Brandon-Valley/Charger-Automation-Board/Car Charger Stuff.docx

Formula Electric

Car Charger

I2C isolator: ISO1541DR

MOSFET: CSD17506Q5A

Low-side MOSFET driver: FAN3214

Cable-pic on phone
