Brandon-Valley/Charger-Automation-Board/Artemis Charger Mod PCB.2.dxf

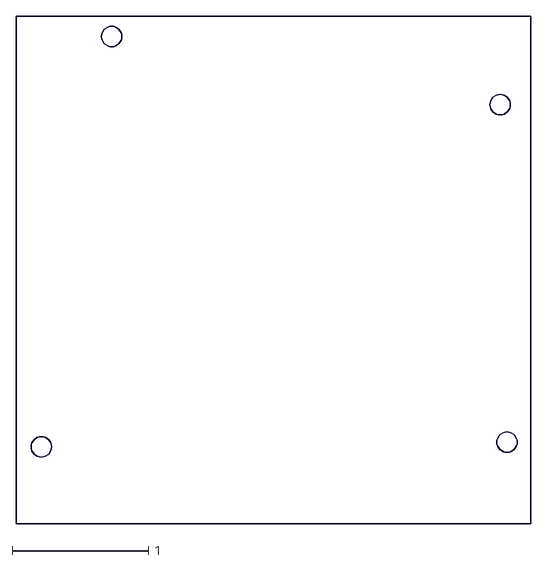
[picture p1: CAD file, 2016-02-05]
Artemis Charger Mod PCB.2.dxf
3.77 x 3.72
