Brandon-Valley/Charger-Automation-Board/Artemis Charger Mod PCB.2.brd

## EAGLE design Artemis Charger Mod PCB.2.brd (2016-01-29)

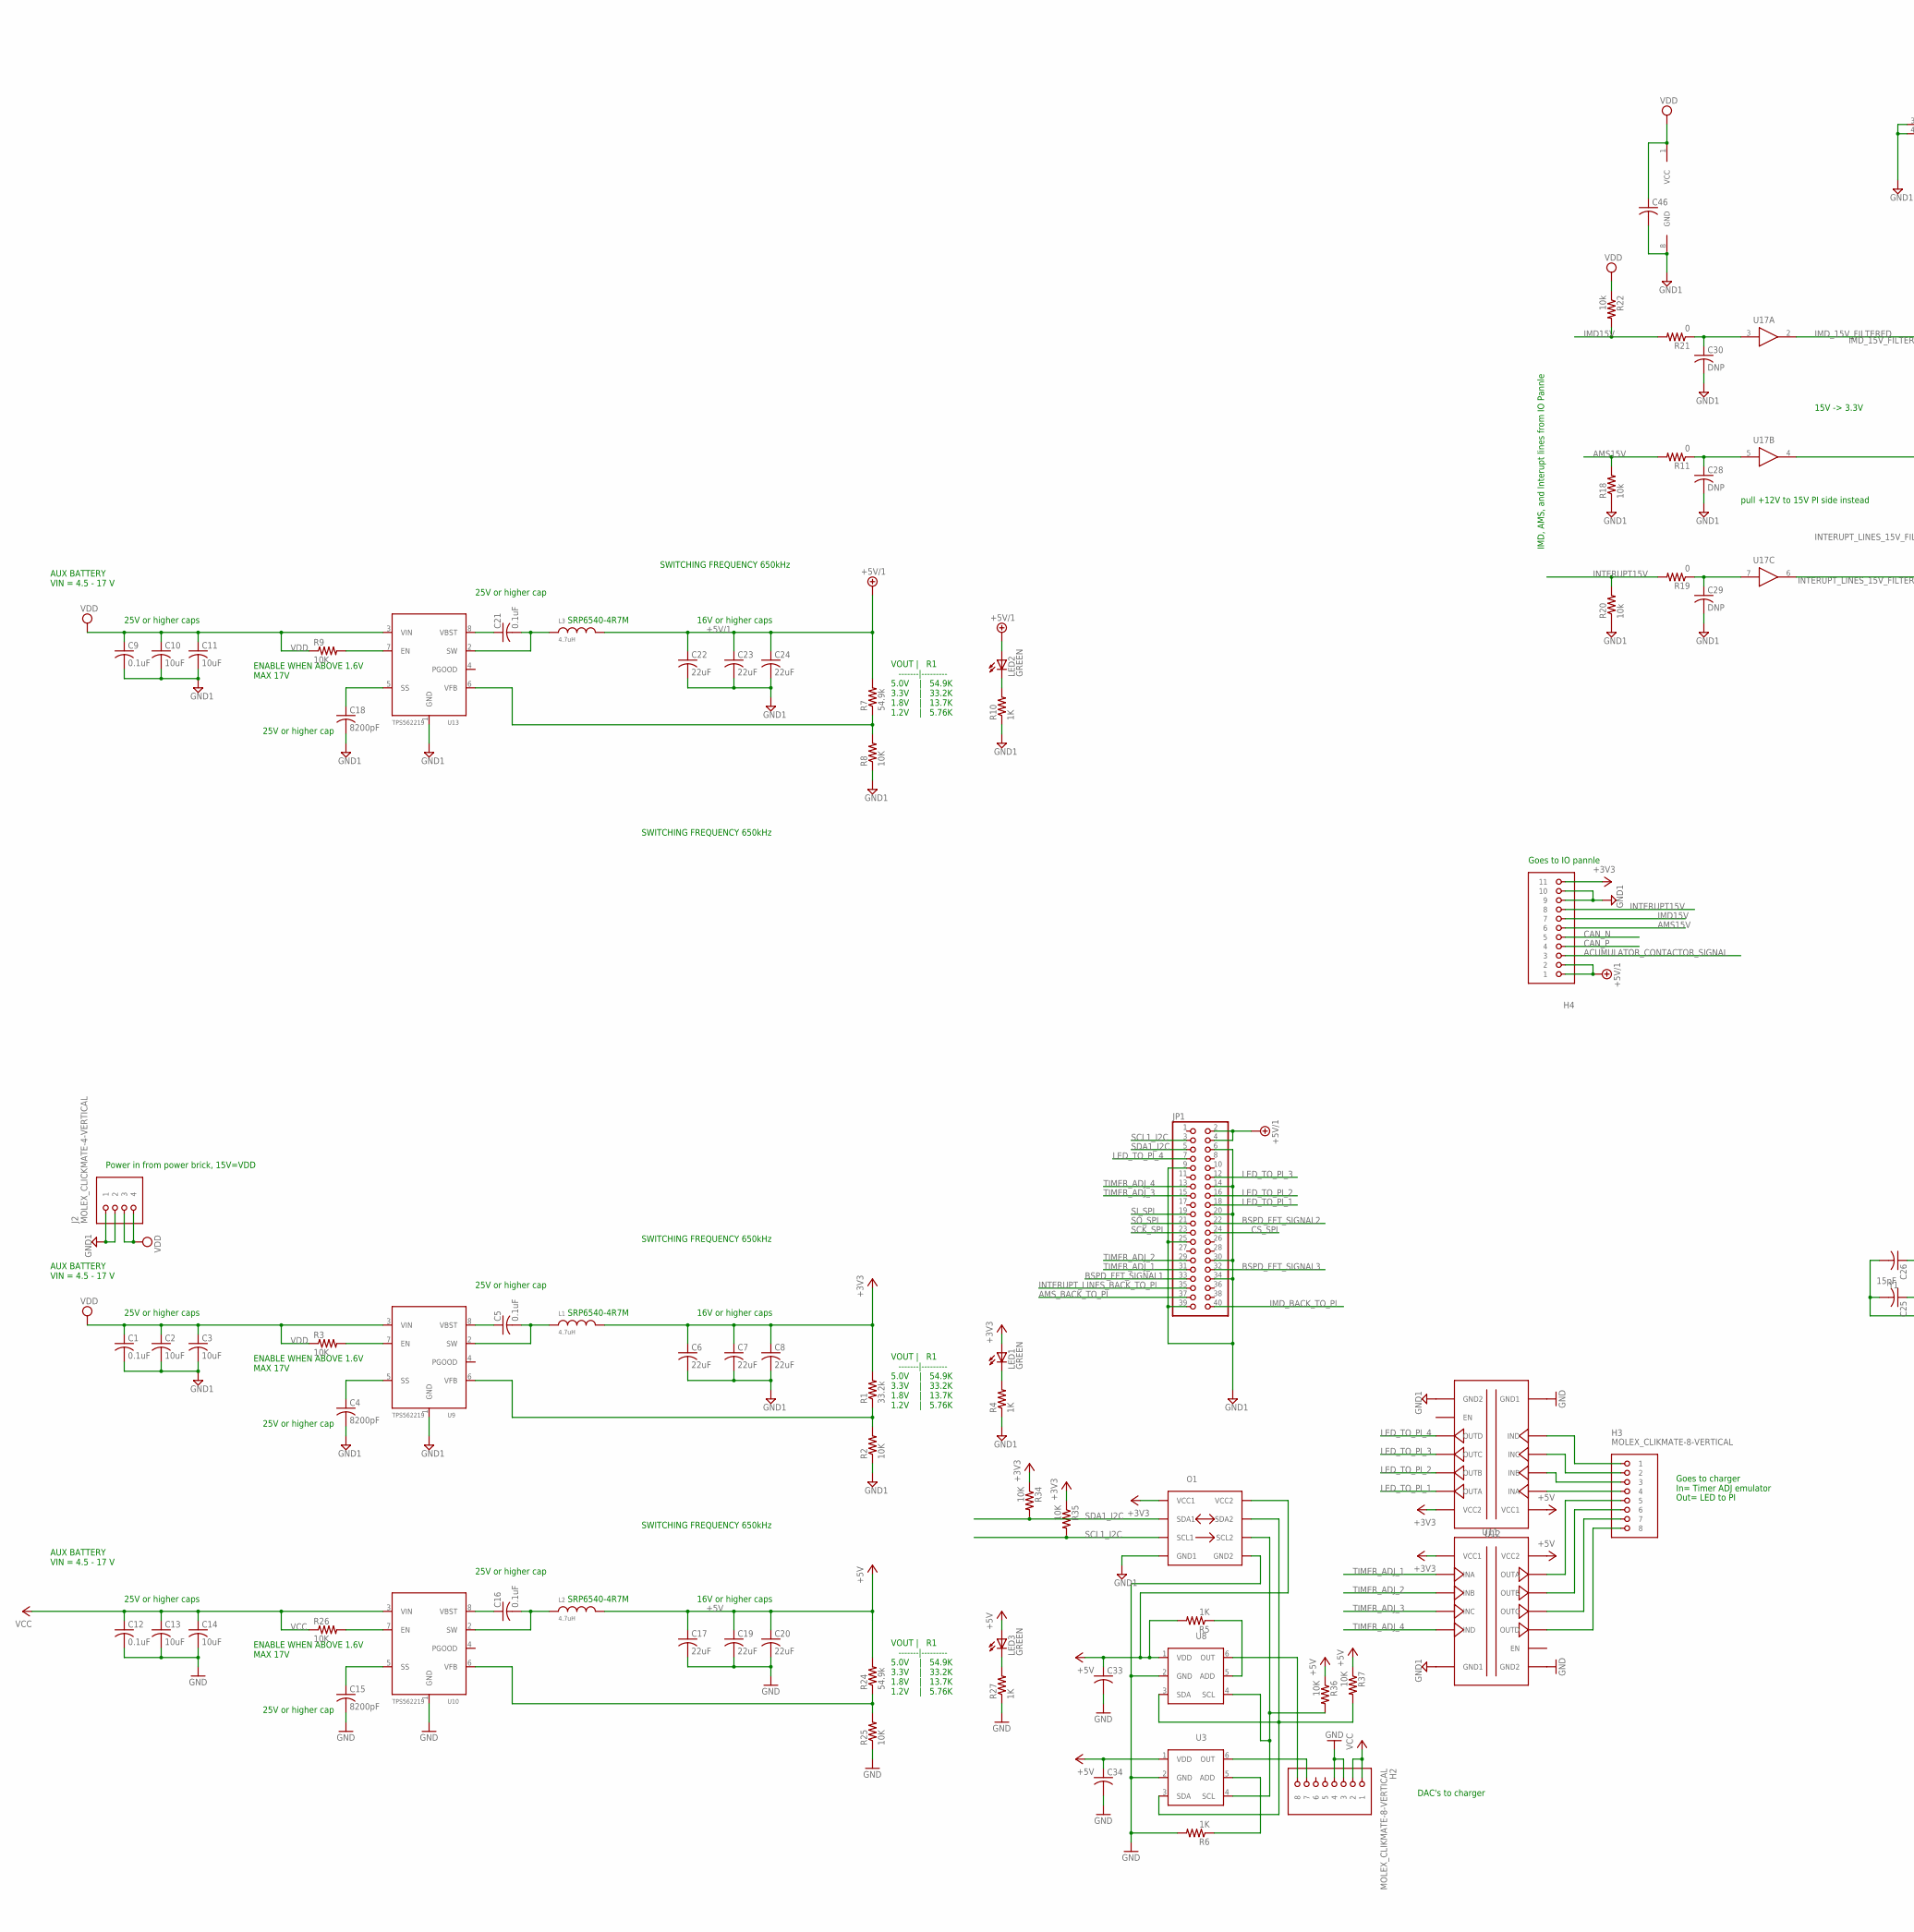
[picture p2: schematic Artemis Charger Mod PCB.2.sch, part in row 1, column 1]

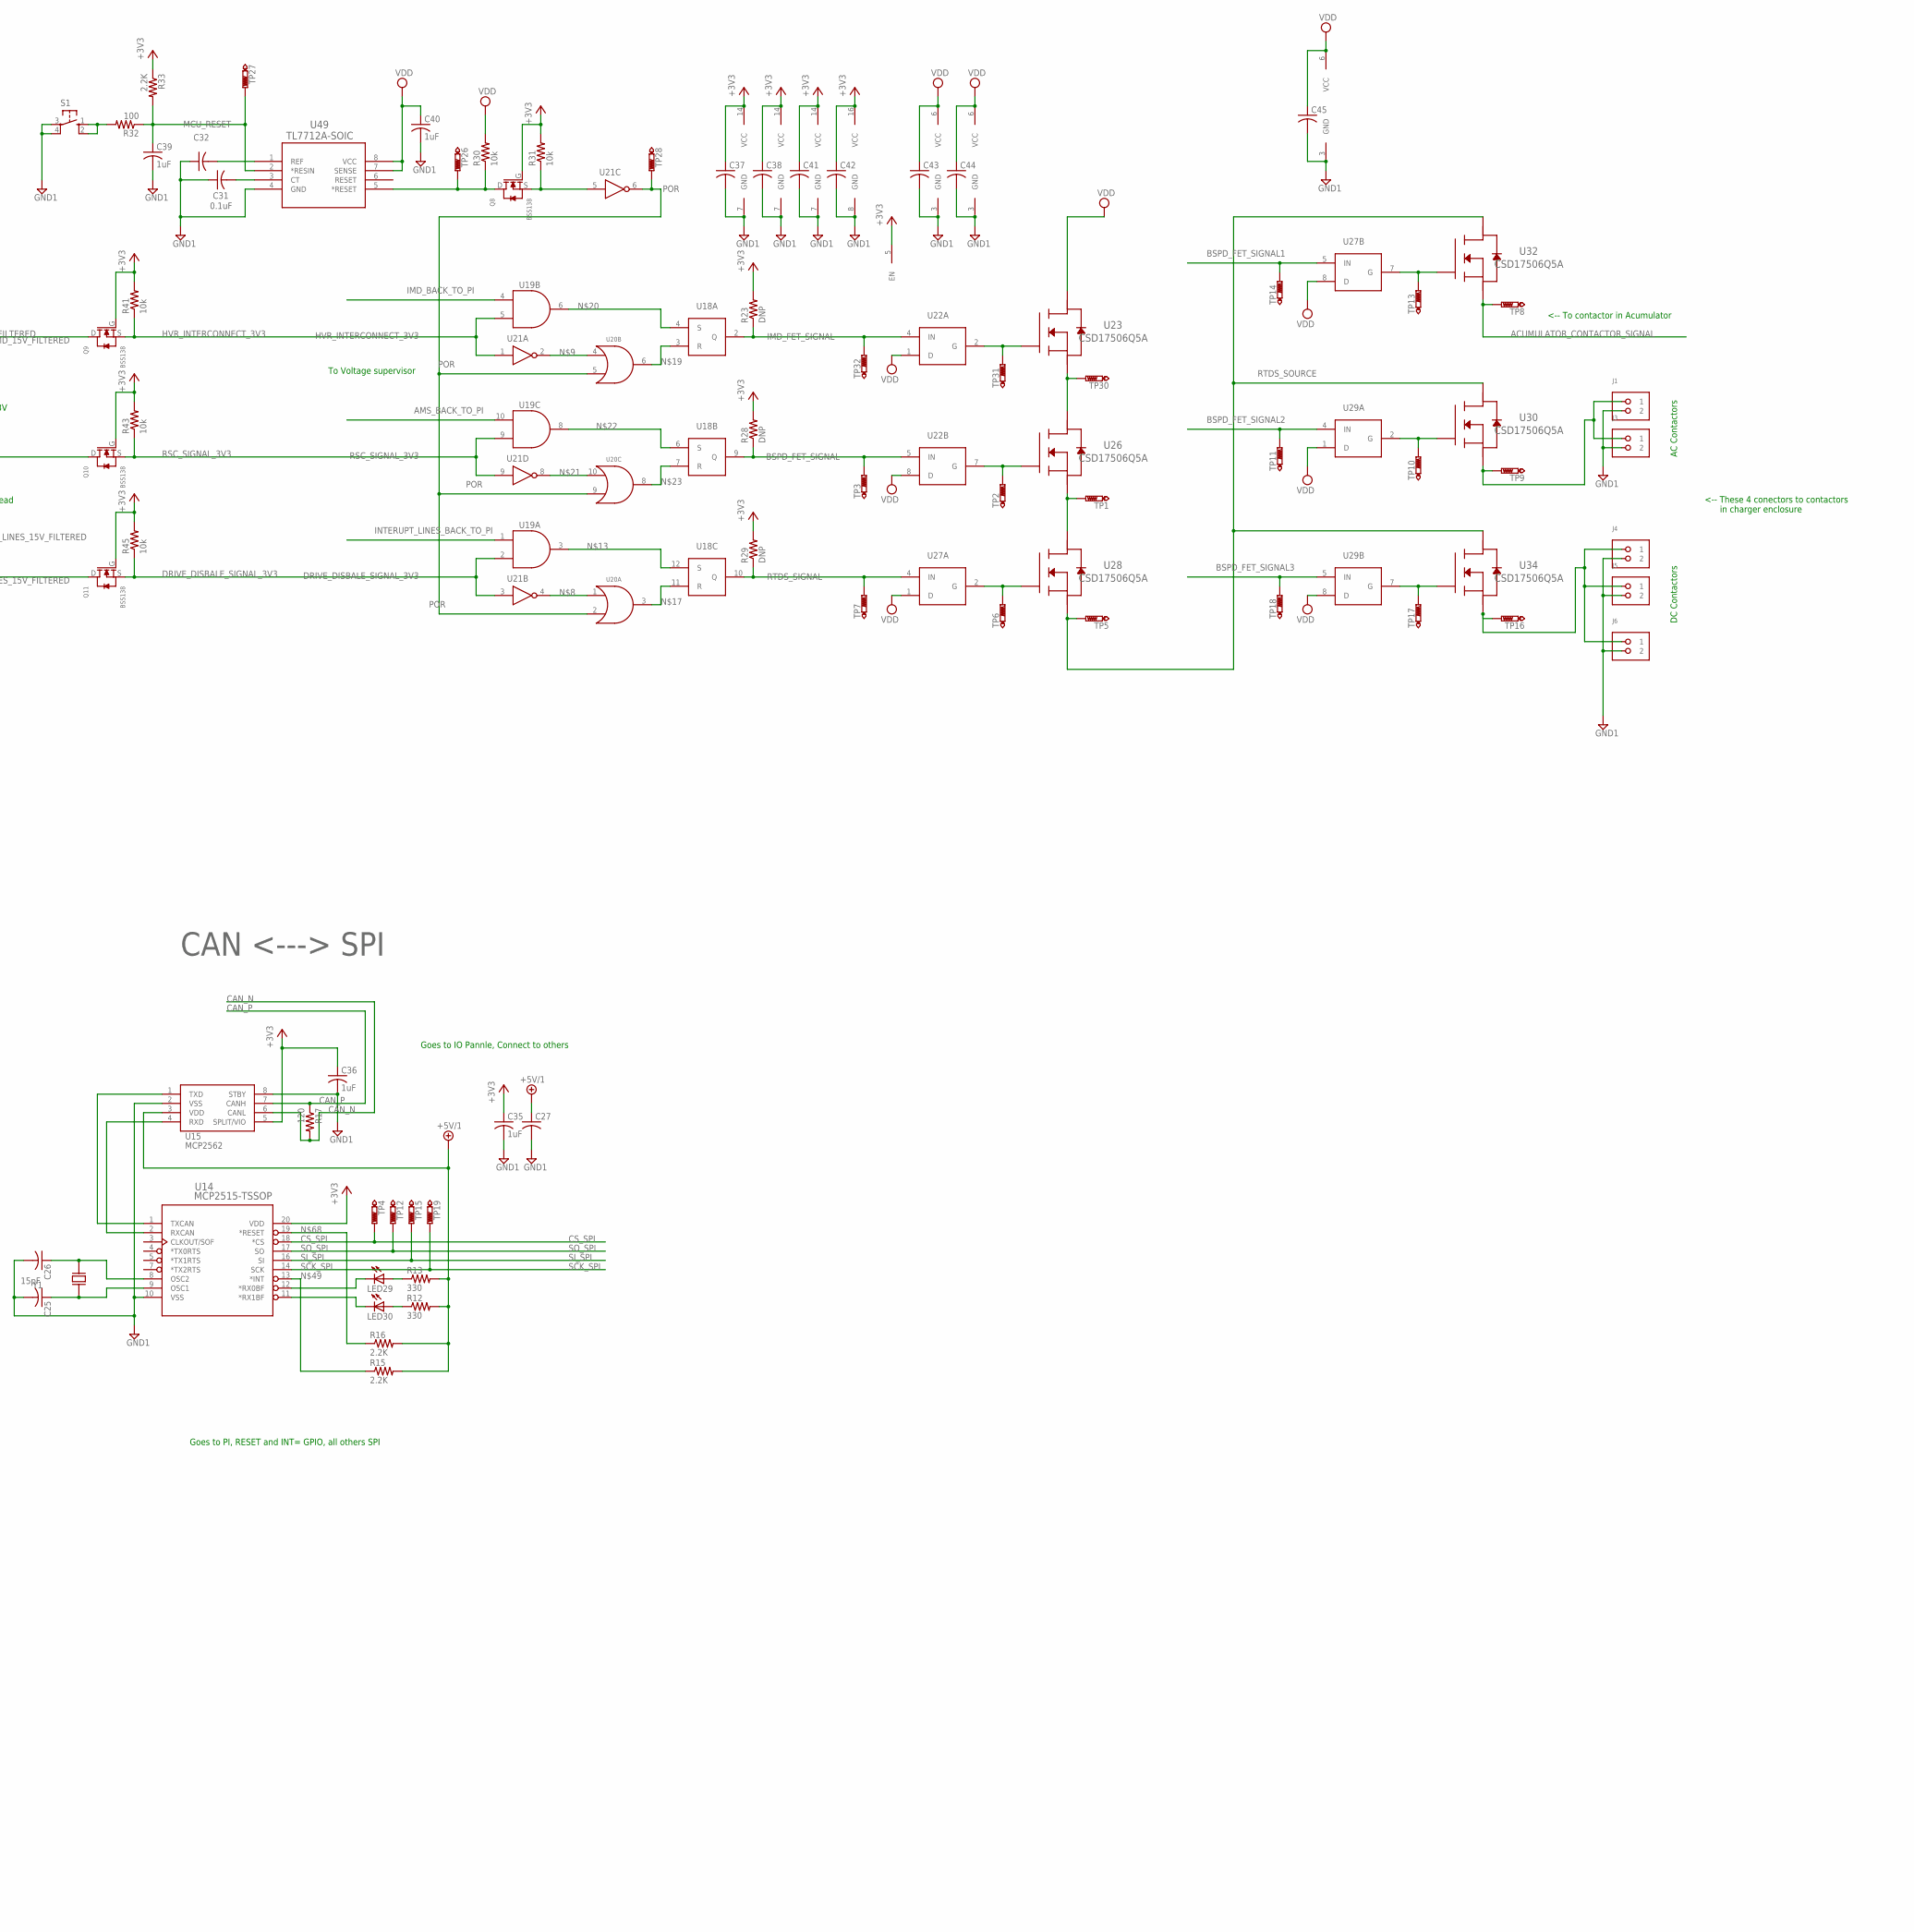
[picture p3: schematic Artemis Charger Mod PCB.2.sch, part in row 1, column 2]

Parts:
C1, C5, C12, C16, C21: 0.1uF; C0805; PARTNO GRM21BR71E104KA01L
C2, C3, C10, C11, C13, C14: 10uF; C0805; PARTNO GRM21BR61E106KA73L
C4, C15, C18: 8200pF; C0805; PARTNO C0805C822K5RACTU
C6, C7, C8, C17, C19, C20, C22, C23, C24: 22uF; C0805; PARTNO C2012JB1E226M125AC
C9: 0.1uF; C0805; PARTNO 5025841170
C25, C26: 15pF; C0805; MPN 08051A150JAT2A
C27, C33, C34, C37, C38, C41, C42, C43, C44, C45, C46: 0.1uF; C0805; MPN C1005X7R1E104K050BB
C28, C29, C30: DNP; C0805
C31, C32: 0.1uF; C0805; MPN C2012X7R1H104K085AA
C35, C36, C39, C40: 1uF; C0805; PARTNO EMK212B7105KG-T
H2, H3: MOLEX_CLIKMATE-8-VERTICAL; MOLEX-CLIKMATE-8-VERTICAL-HEADER; PARTNO 5025840870
H4: MOLEX_CLICKMATE-11-VERTICAL-VERTICAL; MOLEX_CLICKMATE-11-VERTICAL-HEADER; PARTNO 5025841170
J1, J3, J4, J5, J6: MOLEX_CLICKMATE-2-VERTICAL; MOLEX-CLIKMATE-2-VERTICAL-HEADER; PARTNO 5025840270
J2: MOLEX_CLICKMATE-4-VERTICAL; MOLEX-CLIKMATE-4-VERTICAL-HEADER; PARTNO 5040500491
JP1: PINHD-2X20; 2X20; PARTNO 68602-220HLF
L1, L2, L3: 4.7uH; SRP6540; PARTNO SRP6540-4R7M
LED1, LED2, LED3: GREEN; CHIPLED_0805; PARTNO 598-8170-107F
LED29, LED30: LEDCHIP-LED0805; CHIP-LED0805; PARTNO 598-8170-107F
O1: ISO1541; PARTNO ISO1541DR
Q8, Q9, Q10, Q11: BSS138; PARTNO BSS138
R1: 33.2k; R0805; PARTNO 1676307-2
R2, R3, R8, R9, R25, R26, R34, R35, R36, R37: 10K; R0805; PARTNO ERJ-6ENF1002V
R4, R5, R6, R10, R27: 1K; R0805; PARTNO ERJ-6ENF1001V
R7, R24: 54.9k; R0805; PARTNO ERA-6AEB5492V
R11, R19, R21: 0; R0805; PARTNO ERJ-6GEY0R00V
R12, R13: 330; R0805; PARTNO ERJ-P6WF3300V
R15, R16, R33: 2.2K; R0805; PARTNO ERA-6AEB222V
R17: 120; R0805; PARTNO ERJ-6ENF1200V
R18, R20, R22, R30, R31, R41, R43, R45: 10k; R0805; PARTNO ERJ-6ENF1002V
R23, R28, R29: DNP; R0805
R32: 100; R0805; PARTNO ERJ-6ENF1000V
S1: TE-FSM4JSMATR; PARTNO FSM4JSMATR
TP1, TP2, TP3, TP4, TP5, TP6, TP7, TP8, TP9, TP10, TP11, TP12, TP13, TP14, TP15, TP16, TP17, TP18, TP19, TP26, TP27, TP28, TP30, TP31, TP32: PTR1TP20R; TP20R
U3, U8: MAX5812LEUT+TCT-ND; MAX5812; PARTNO MAX5812LEUT+T
U9, U10, U13: TPS562219; PARTNO TPS562219DDFT
U11, U12: ISO7340; ISO734X; PARTNO ISO7340CDWR
U14: MCP2515-TSSOP; TSSOP20_MC; MPN MCP2515-E/ST
U15: MCP2562; SOIC8-N_MC; MPN MCP2562-E/SN
U17: CD4050BD; SOIC-16; PARTNO CD4050BDR
U18: CD4043B; PW16-M; PARTNO CD4043BPWR
U19: SN74LVC08ASOIC; D14; PARTNO SN74LVC08ADR
U20: SN74LVC32ASOIC; D14; PARTNO SN74LVC32ADR
U21: SN74LVC04ASOIC; SOIC-14; PARTNO SN74LVC04ADR
U22, U27, U29: LTC1155; LT-SOL8; PARTNO LTC1155CS8#PBF
U23, U26, U28, U30, U32, U34: CSD17506Q5A; SON_5X6; PARTNO CSD17506Q5A
U49: TL7712A-SOIC; D8; MPN TL7705BID
Y1: CSM-3X; PARTNO ECS-160-20-3X-TR

Connections:
+3V3: C6.1, C7.1, C8.1, C35.1, C36.1, C37.1, C38.1, C41.1, C42.1, H4.11, L1.P$2, LED1.A, O1.1 (VCC1), Q8.G, Q9.G, Q10.G, Q11.G, R1.2, R23.2, R28.2, R29.2, R31.2, R33.1, R34.1, R35.1, R41.2, R43.2, R45.2, U11.P$1 (VCC1), U12.P$16 (VCC2), U14.20 (VDD), U15.5 (SPLIT/VIO), U18.5 (EN), U18.16 (VCC), U19.14 (VCC), U20.14 (VCC), U21.14 (VCC)
+5V: C17.1, C19.1, C20.1, C33.1, C34.1, L2.P$2, LED3.A, O1.8 (VCC2), R5.2, R24.2, R36.1, R37.1, U3.1 (VDD), U8.1 (VDD), U11.P$16 (VCC2), U12.P$1 (VCC1)
+5V/1: C22.1, C23.1, C24.1, C27.1, H4.1, H4.2, JP1.2, JP1.4, L3.P$2, LED2.A, R7.2, R12.2, R13.2, R15.2, R16.2, U15.3 (VDD)
ACUMULATOR_CONTACTOR_SIGNAL: H4.3, TP8.TP, U32.1 (S), U32.2 (S), U32.3 (S)
ADD: R6.1, U3.5 (ADD)
AMS15V: H4.6, R11.2, R18.2
AMS_15V_FILTERED: Q10.D, U17.4 (OUT)
AMS_BACK_TO_PI: JP1.37, U19.10 (IN1)
BSPD_FET_SIGNAL: R28.1, TP3.TP, U18.9 (Q), U22.5 (IN)
BSPD_FET_SIGNAL1: JP1.33, TP14.TP, U27.5 (IN)
BSPD_FET_SIGNAL2: JP1.22, TP11.TP, U29.4 (IN)
BSPD_FET_SIGNAL3: JP1.32, TP18.TP, U29.5 (IN)
CAN_N: H4.5, R17.2, U15.6 (CANL)
CAN_P: H4.4, R17.1, U15.7 (CANH)
CS_SPI: JP1.24, TP4.TP, U14.18 (*CS)
DRIVE_DISBALE_SIGNAL_3V3: Q11.S, R45.1, U19.2 (IN2), U21.3 (IN)
FET_CONNECT_1: TP30.TP, U23.1 (S), U23.2 (S), U23.3 (S), U26.5 (D), U26.6 (D), U26.7 (D), U26.8 (D), U26.PAD (D), U26.PAD1 (D), U26.VIA1 (D), U26.VIA2 (D), U26.VIA3 (D), U26.VIA4 (D), U26.VIA5 (D), U26.VIA6 (D), U26.VIA7 (D), U26.VIA8 (D), U26.VIA9 (D)
FET_CONNECT_2: TP1.TP, U26.1 (S), U26.2 (S), U26.3 (S), U28.5 (D), U28.6 (D), U28.7 (D), U28.8 (D), U28.PAD (D), U28.PAD1 (D), U28.VIA1 (D), U28.VIA2 (D), U28.VIA3 (D), U28.VIA4 (D), U28.VIA5 (D), U28.VIA6 (D), U28.VIA7 (D), U28.VIA8 (D), U28.VIA9 (D)
GND: C12.2, C13.2, C14.2, C15.2, C17.2, C19.2, C20.2, C33.2, C34.2, H2.3, H2.4, O1.5 (GND2), R6.2, R25.1, R27.1, U3.2 (GND), U8.2 (GND), U10.1 (GND), U11.P$9 (GND2), U11.P$15 (GND2), U12.P$2 (GND1), U12.P$8 (GND1)
GND1: C1.2, C2.2, C3.2, C4.2, C6.2, C7.2, C8.2, C9.2, C10.2, C11.2, C18.2, C22.2, C23.2, C24.2, C25.2, C26.2, C27.2, C28.2, C29.2, C30.2, C31.1, C32.1, C35.2, C36.2, C37.2, C38.2, C39.2, C40.2, C41.2, C42.2, C43.2, C44.2, C45.2, C46.2, H4.9, H4.10, J1.2, J2.1, J2.2, J3.2, J4.2, J5.2, J6.2, JP1.6, JP1.9, JP1.14, JP1.20, JP1.25, JP1.30, JP1.34, JP1.39, O1.4 (GND1), R2.1, R4.1, R8.1, R10.1, R18.1, R20.1, S1.3, S1.4, U9.1 (GND), U11.P$2 (GND1), U11.P$8 (GND1), U12.P$9 (GND2), U12.P$15 (GND2), U13.1 (GND), U14.10 (VSS), U15.2 (VSS), U15.8 (STBY), U17.8 (GND), U18.8 (GND), U19.7 (GND), U20.7 (GND), U21.7 (GND), U22.3 (GND), U27.3 (GND), U29.3 (GND), U49.4 (GND)
HVR_INTERCONNECT_3V3: Q9.S, R41.1, U19.5 (IN2), U21.1 (IN)
IMD15V: H4.7, R21.2, R22.2
IMD_15V_FILTERED: Q9.D, U17.2 (OUT)
IMD_BACK_TO_PI: JP1.40, U19.4 (IN1)
IMD_FET_SIGNAL: R23.1, TP32.TP, U18.2 (Q), U22.4 (IN)
INTERUPT15V: H4.8, R19.2, R20.2
INTERUPT_LINES_15V_FILTERED: Q11.D, U17.6 (OUT)
INTERUPT_LINES_BACK_TO_PI: JP1.35, U19.1 (IN1)
LED_TO_PI_1: JP1.18, U12.P$14 (OUTA)
LED_TO_PI_1_C: H3.1, U12.P$6 (IND)
LED_TO_PI_2: JP1.16, U12.P$13 (OUTB)
LED_TO_PI_2_C: H3.2, U12.P$5 (INC)
LED_TO_PI_3: JP1.12, U12.P$12 (OUTC)
LED_TO_PI_3_C: H3.3, U12.P$4 (INB)
LED_TO_PI_4: JP1.7, U12.P$11 (OUTD)
LED_TO_PI_4_C: H3.4, U12.P$3 (INA)
MCU_RESET: C39.1, R32.1, R33.2, TP27.TP, U49.2 (*RESIN)
unnamed: R3.2, U9.7 (EN)
unnamed: LED1.C, R4.2
unnamed: R5.1, U8.5 (ADD)
unnamed: J4.1, J5.1, J6.1, TP16.TP, U34.1 (S), U34.2 (S), U34.3 (S)
unnamed: U20.1 (IN1), U21.4 (OUT)
unnamed: U20.4 (IN1), U21.2 (OUT)
unnamed: U18.12 (S), U19.3 (OUT)
unnamed: U18.11 (R), U20.3 (OUT)
unnamed: U18.3 (R), U20.6 (OUT)
unnamed: U18.4 (S), U19.6 (OUT)
unnamed: U20.10 (IN1), U21.8 (OUT)
unnamed: U18.6 (S), U19.8 (OUT)
unnamed: U18.7 (R), U20.8 (OUT)
unnamed: H2.7, U3.6 (OUT)
unnamed: H2.8, U8.6 (OUT)
unnamed: LED3.C, R27.2
unnamed: H3.5, U11.P$14 (OUTA)
unnamed: H3.6, U11.P$13 (OUTB)
unnamed: H3.7, U11.P$12 (OUTC)
unnamed: H3.8, U11.P$11 (OUTD)
unnamed: C28.1, R11.1, U17.5 (IN)
unnamed: R9.2, U13.7 (EN)
unnamed: LED2.C, R10.2
unnamed: U14.2 (RXCAN), U15.4 (RXD)
unnamed: U14.1 (TXCAN), U15.1 (TXD)
unnamed: R15.1, U14.13 (*INT)
unnamed: C29.1, R19.1, U17.7 (IN)
unnamed: C30.1, R21.1, U17.3 (IN)
unnamed: TP31.TP, U22.2 (G), U23.4 (G)
unnamed: TP2.TP, U22.7 (G), U26.4 (G)
unnamed: TP6.TP, U27.2 (G), U28.4 (G)
unnamed: TP10.TP, U29.2 (G), U30.4 (G)
unnamed: Q8.S, R31.1, U21.5 (IN)
unnamed: TP13.TP, U27.7 (G), U32.4 (G)
unnamed: Q8.D, R30.1, TP26.TP, U49.5 (*RESET)
unnamed: R32.2, S1.1, S1.2
unnamed: TP17.TP, U29.7 (G), U34.4 (G)
unnamed: R16.1, U14.19 (*RESET)
unnamed: LED30.C, U14.11 (*RX1BF)
unnamed: LED29.C, U14.12 (*RX0BF)
unnamed: LED30.A, R12.1
unnamed: LED29.A, R13.1
unnamed: C26.1, U14.8 (OSC2), Y1.P$1
unnamed: C25.1, U14.9 (OSC1), Y1.P$2
unnamed: C31.2, U49.3 (CT)
unnamed: C32.2, U49.1 (REF)
unnamed: R26.2, U10.7 (EN)
POR: TP28.TP, U20.2 (IN2), U20.5 (IN2), U20.9 (IN2), U21.6 (OUT)
RSC_SIGNAL_3V3: Q10.S, R43.1, U19.9 (IN2), U21.9 (IN)
RTDS_SIGNAL: R29.1, TP7.TP, U18.10 (Q), U27.4 (IN)
RTDS_SOURCE: TP5.TP, U28.1 (S), U28.2 (S), U28.3 (S), U30.5 (D), U30.6 (D), U30.7 (D), U30.8 (D), U30.PAD (D), U30.PAD1 (D), U30.VIA1 (D), U30.VIA2 (D), U30.VIA3 (D), U30.VIA4 (D), U30.VIA5 (D), U30.VIA6 (D), U30.VIA7 (D), U30.VIA8 (D), U30.VIA9 (D), U32.5 (D), U32.6 (D), U32.7 (D), U32.8 (D), U32.PAD (D), U32.PAD1 (D), U32.VIA1 (D), U32.VIA2 (D), U32.VIA3 (D), U32.VIA4 (D), U32.VIA5 (D), U32.VIA6 (D), U32.VIA7 (D), U32.VIA8 (D), U32.VIA9 (D), U34.5 (D), U34.6 (D), U34.7 (D), U34.8 (D), U34.PAD (D), U34.PAD1 (D), U34.VIA1 (D), U34.VIA2 (D), U34.VIA3 (D), U34.VIA4 (D), U34.VIA5 (D), U34.VIA6 (D), U34.VIA7 (D), U34.VIA8 (D), U34.VIA9 (D)
RTDS_SOURCE1: J1.1, J3.1, TP9.TP, U30.1 (S), U30.2 (S), U30.3 (S)
SCK_SPI: JP1.23, TP19.TP, U14.14 (SCK)
SCL: O1.6 (SCL2), R36.2, U3.4 (SCL), U8.4 (SCL)
SCL1_I2C: JP1.3, O1.3 (SCL1), R35.2
SDA: O1.7 (SDA2), R37.2, U3.3 (SDA), U8.3 (SDA)
SDA1_I2C: JP1.5, O1.2 (SDA1), R34.2
SI_SPI: JP1.19, TP15.TP, U14.16 (SI)
SO_SPI: JP1.21, TP12.TP, U14.17 (SO)
SS_3V3: C4.1, U9.5 (SS)
SS_5V: C15.1, U10.5 (SS)
SS_5V2: C18.1, U13.5 (SS)
SW_3V3: C5.2, L1.P$1, U9.2 (SW)
SW_5V: C16.2, L2.P$1, U10.2 (SW)
SW_5V/1: C21.2, L3.P$1, U13.2 (SW)
TIMER_ADJ_1: JP1.31, U11.P$3 (INA)
TIMER_ADJ_2: JP1.29, U11.P$4 (INB)
TIMER_ADJ_3: JP1.15, U11.P$5 (INC)
TIMER_ADJ_4: JP1.13, U11.P$6 (IND)
VBST_3V3: C5.1, U9.8 (VBST)
VBST_5V: C16.1, U10.8 (VBST)
VBST_5V/1: C21.1, U13.8 (VBST)
VCC: C12.1, C13.1, C14.1, H2.1, H2.2, R26.1, U10.3 (VIN)
VDD: C1.1, C2.1, C3.1, C9.1, C10.1, C11.1, C40.1, C43.1, C44.1, C45.1, C46.1, J2.3, J2.4, R3.1, R9.1, R22.1, R30.2, U9.3 (VIN), U13.3 (VIN), U17.1 (VCC), U22.1 (D), U22.6 (VCC), U22.8 (D), U23.5 (D), U23.6 (D), U23.7 (D), U23.8 (D), U23.PAD (D), U23.PAD1 (D), U23.VIA1 (D), U23.VIA2 (D), U23.VIA3 (D), U23.VIA4 (D), U23.VIA5 (D), U23.VIA6 (D), U23.VIA7 (D), U23.VIA8 (D), U23.VIA9 (D), U27.1 (D), U27.6 (VCC), U27.8 (D), U29.1 (D), U29.6 (VCC), U29.8 (D), U49.7 (SENSE), U49.8 (VCC)
VFB_3V3: R1.1, R2.2, U9.6 (VFB)
VFB_5V: R24.1, R25.2, U10.6 (VFB)
VFB_5V/1: R7.1, R8.2, U13.6 (VFB)

Notes on the sheet:
AUX BATTERY VIN = 4.5 - 17 V
VOUT | R1 -------|--------- 5.0V | 54.9K 3.3V | 33.2K 1.8V | 13.7K 1.2V | 5.76K
SRP6540-4R7M
SWITCHING FREQUENCY 650kHz
ENABLE WHEN ABOVE 1.6V MAX 17V
25V or higher caps
25V or higher cap
16V or higher caps
Goes to IO Pannle, Connect to others
Goes to charger In= Timer ADJ emulator
Out= LED to PI
Power in from power brick, 15V=VDD
DAC's to charger
Goes to IO pannle
Goes to PI, RESET and INT= GPIO, all others SPI
pull +12V to 15V PI side instead
15V -> 3.3V
To Voltage supervisor
IMD, AMS, and Interupt lines from IO Pannle
<-- These 4 conectors to contactors in charger enclosure
<-- To contactor in Acumulator
CAN <---> SPI
DC Contactors
AC Contactors

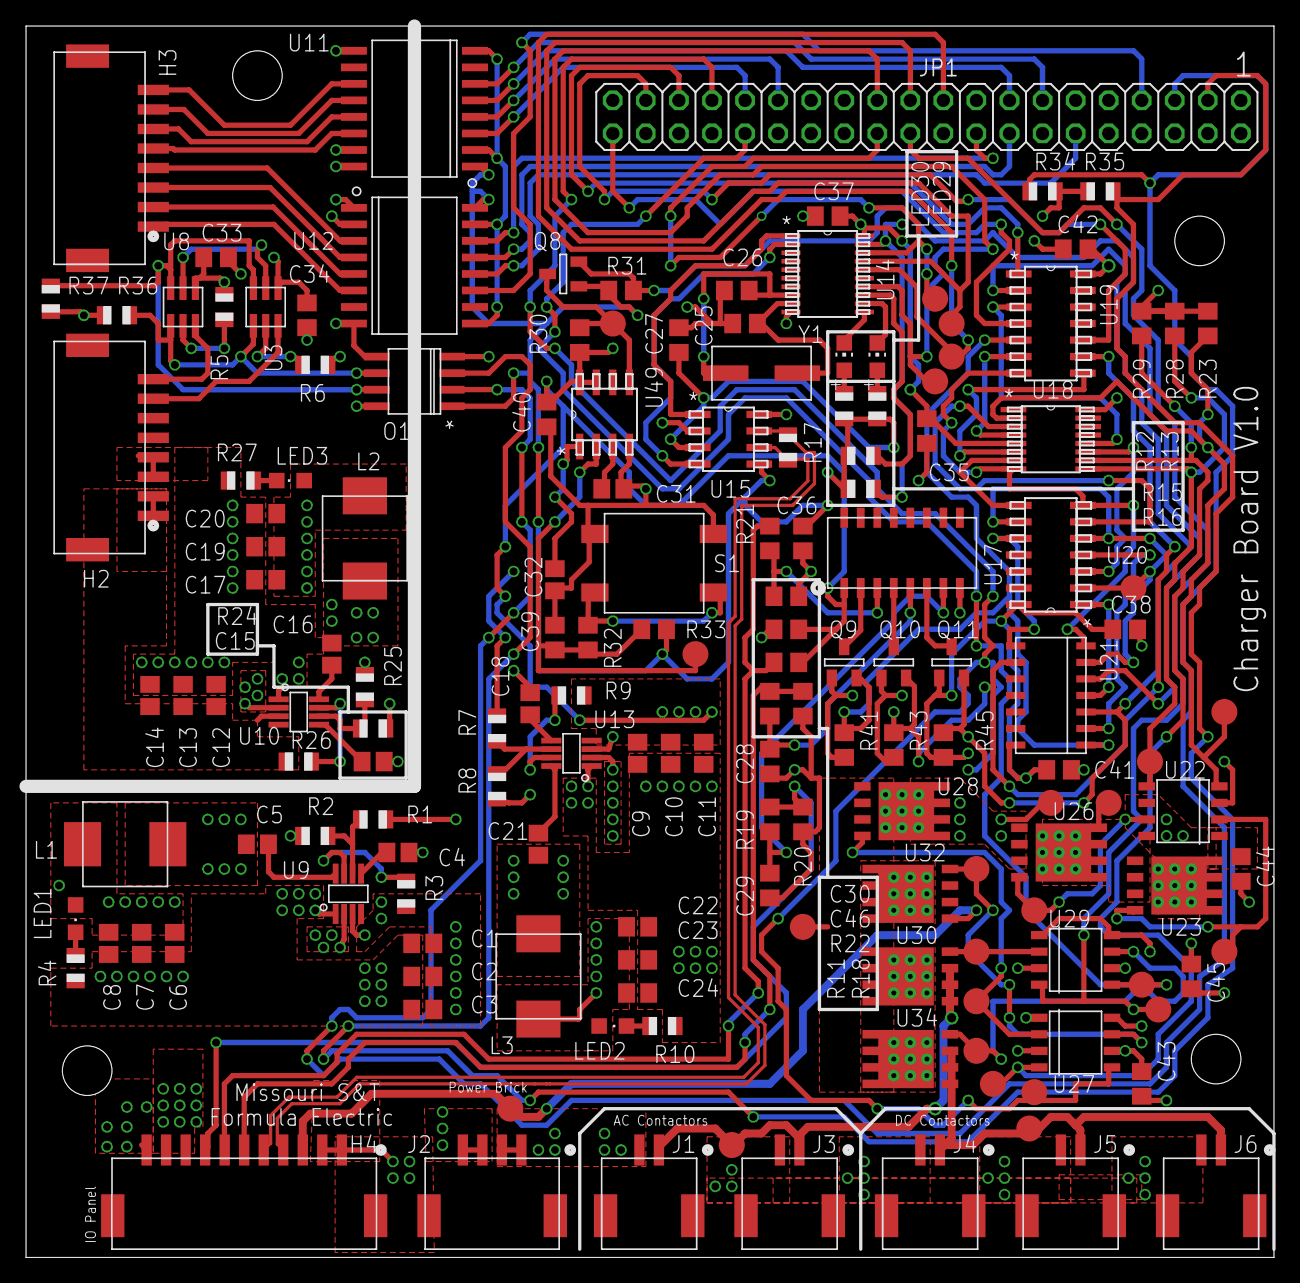
[picture p4: board Artemis Charger Mod PCB.2.brd from above]

Board: 4 copper layers, 95.9 x 94.6 mm, 159 parts (0 on the bottom side), 114 nets.
