Brandon-Valley/Charger-Automation-Board/(commit log)

2015-11-28 Artemis Charger Mod PCB: Modification to the Manzanita Micro PFC Charger: Allows for remote control of the charger, removing the need for the knobs // Also includes connection between the Raspberry P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
    [Artemis Charger Mod PCB.brd, Artemis Charger Mod PCB.sch]
2015-12-30 Almost Done
    [Artemis Charger Mod PCB.1.brd, Artemis Charger Mod PCB.1.sch, Artemis Charger Mod PCB.2.brd, Artemis Charger Mod PCB.2.sch, Artemis Charger Mod PCB.brd, Artemis Charger Mod PCB.sch]
2015-12-31 Added BOM
    [Artemis Charger Mod PCB.2.brd, Artemis Charger Mod PCB.2.sch, Artemis Charger Mod PCB.2_OrderUploadDigiKey.csv]
2016-01-04 Fixed list of errors: Too many vias around regulators
    Make +5V plane in cover all area in isolated region
    Make isolation barrier a simple rectangle
    rotate +5v regulator (isolated area) 180deg so that the current path is more direct
    More vias/planes at connectors
    Give nets a descriptive name
    Use vector font
    U16/17/25 should combine into one part
    bypass caps on ICs
    U22/24/27/29/31/33 can be combined into 3 parts
    RTDS_SOURCE is connected to FETs that it shouldn't be
    U18 has a floating EN pin
    use planes for current paths to the FETs, and make sure to connect to all of the pads (3 source, 4+pad drain)
    Check pin current limits of connectors
    Can use 10mil traces if needed for signals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
    [Artemis Charger Mod Mystery Part Pin-out.xlsx, Artemis Charger Mod PCB.2.brd, Artemis Charger Mod PCB.2.sch, Artemis Charger Mod PCB.sch]
2016-01-07 Started cleaning up layout
    [Artemis Charger Mod PCB.2.brd, Artemis Charger Mod PCB.2.sch]
2016-01-07 Fixed second list of errors: Decoupling capacitors
    U11/12 EN pin is floating
    Don't use solid planes at FET drivers
    Lots of random vias
    Planes from FETs to contactor connector
    Connector labels
    Cleanup supply layer planes
    Isolation line needs to be thru center of isolators
    unnecessary vias at raspi connector
    SPI interface
    [Artemis Charger Mod PCB.2.brd, Artemis Charger Mod PCB.2.sch]
2016-01-07 Fixed LED Silkscreens
    [Artemis Charger Mod PCB.2.brd]
2016-01-08 Added extra contactor for charger discharge
    [Artemis Charger Mod PCB.2.brd, Artemis Charger Mod PCB.2.sch]
2016-01-12 Fixed fixed silk screens, fixed a few overlap errors
    [Artemis Charger Mod PCB.2.brd, Artemis Charger Mod PCB.2.sch]
2016-01-20 Fixed crooked supply planes, moved planes away from isolation line, made better silkscreens, about to do BOM
    [Artemis Charger Mod PCB.2.brd]
2016-01-20 Added molex 1 pin and 2X20 header to BOM
    [Artemis Charger Mod PCB.2.brd, Artemis Charger Mod PCB.2.sch]
2016-01-21 Changes supply Plane
    [Artemis Charger Mod PCB.2.brd]
2016-01-21 Added CAM Files
    [Artemis Charger Mod PCB.2_BottomCopper.GBL, Artemis Charger Mod PCB.2_BottomMask.GBS, Artemis Charger Mod PCB.2_BottomSilkS.GBO, Artemis Charger Mod PCB.2_Drill.XLN, Artemis Charger Mod PCB.2_Outline.GKO, Artemis Charger Mod PCB.2_TopCopper.GTL, Artemis Charger Mod PCB.2_TopMask.GTS, Artemis Charger Mod PCB.2_TopSilkS.GTO]
2016-01-29 Added STENCIL
    [Artemis Charger Mod PCB.2.brd, Artemis Charger Mod PCB.2.sch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]
2016-01-29 Added STENCIL and cleaned up folder
    [Artemis Charger Mod PCB.1.brd, Artemis Charger Mod PCB.1.sch, Artemis Charger Mod PCB.brd, Artemis Charger Mod PCB.sch]
2016-02-05 Added DXF
    [Artemis Charger Mod PCB.2.dxf]
